motii8128/TRIA/README.md

# TRIA
Triple-wheel Robot for Intelligent Autonomous

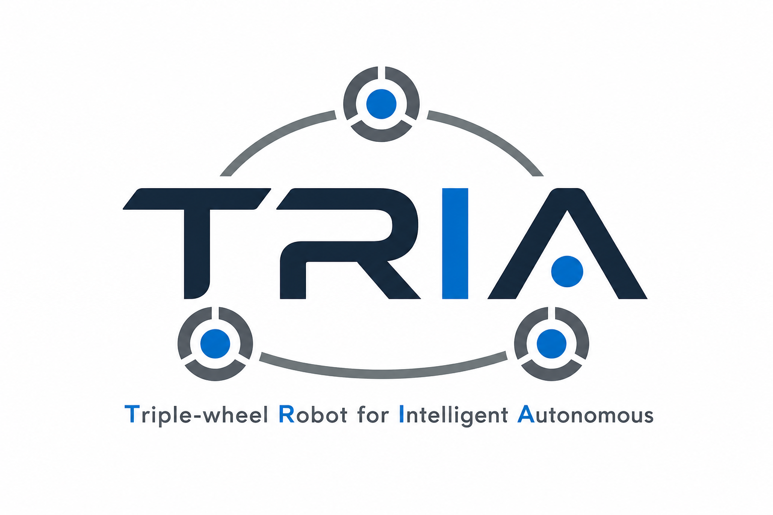
[picture p1: tria_logo.png]


# install
```
sudo apt install nlohmann-json3-dev
sudo apt install protobuf-compiler
```
