motii8128/TRIA/control_architecture.md

# 制御アーキテクチャ
```mermaid
graph TD

subgraph hardware
micro_controller <==> |CAN| RoboMaster
micro_controller <==> |CAN| MotorDriver
end

subgraph software
micro_controller_connector <==>|UDP| micro_controller
wheel_controller ==> micro_controller_connector
machine_controller ==> micro_controller_connector
tria_auto_core ==> wheel_controller
tria_auto_core ==> machine_controller
end
```
