motii8128/TRIA/tria_hardware/TRIA_ControlPowerBoard/TRIA_ControlPowerBoard.step

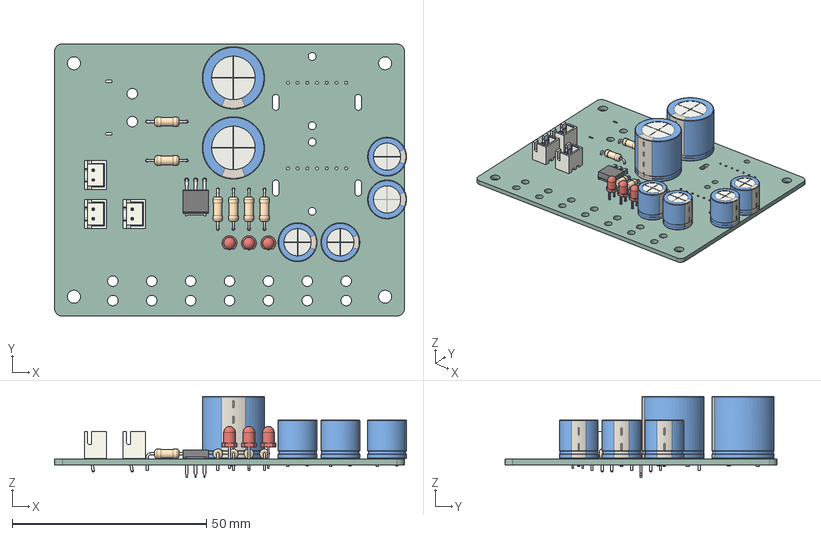
[picture p2: CAD file, 2026-09-30]
tria_hardware/TRIA_ControlPowerBoard/TRIA_ControlPowerBoard.step
90.5 x 70.0 x 20.8 mm
CP_Radial_D10.0mm_P5.00mm x 4
LED_D3.0mm x 3
R_Axial_DIN0207_L6.3mm_D2.5mm_P10.16mm_Horizontal x 6
JST_XH_B2B-XH-A_1x02_P2.50mm_Vertical x 3
CP_Radial_D16.0mm_P7.50mm x 2
TO-251-3-1EP_Horizontal_TabDown
TRIA_ControlPowerBoard_PCB
