motii8128/TRIA/tria_hardware/TRIA_CentralControlBoard/TRIA_CentralControlBoard.kicad_pcb

## KiCad design tria_hardware/TRIA_CentralControlBoard/TRIA_CentralControlBoard.kicad_pcb (2026-09-16)

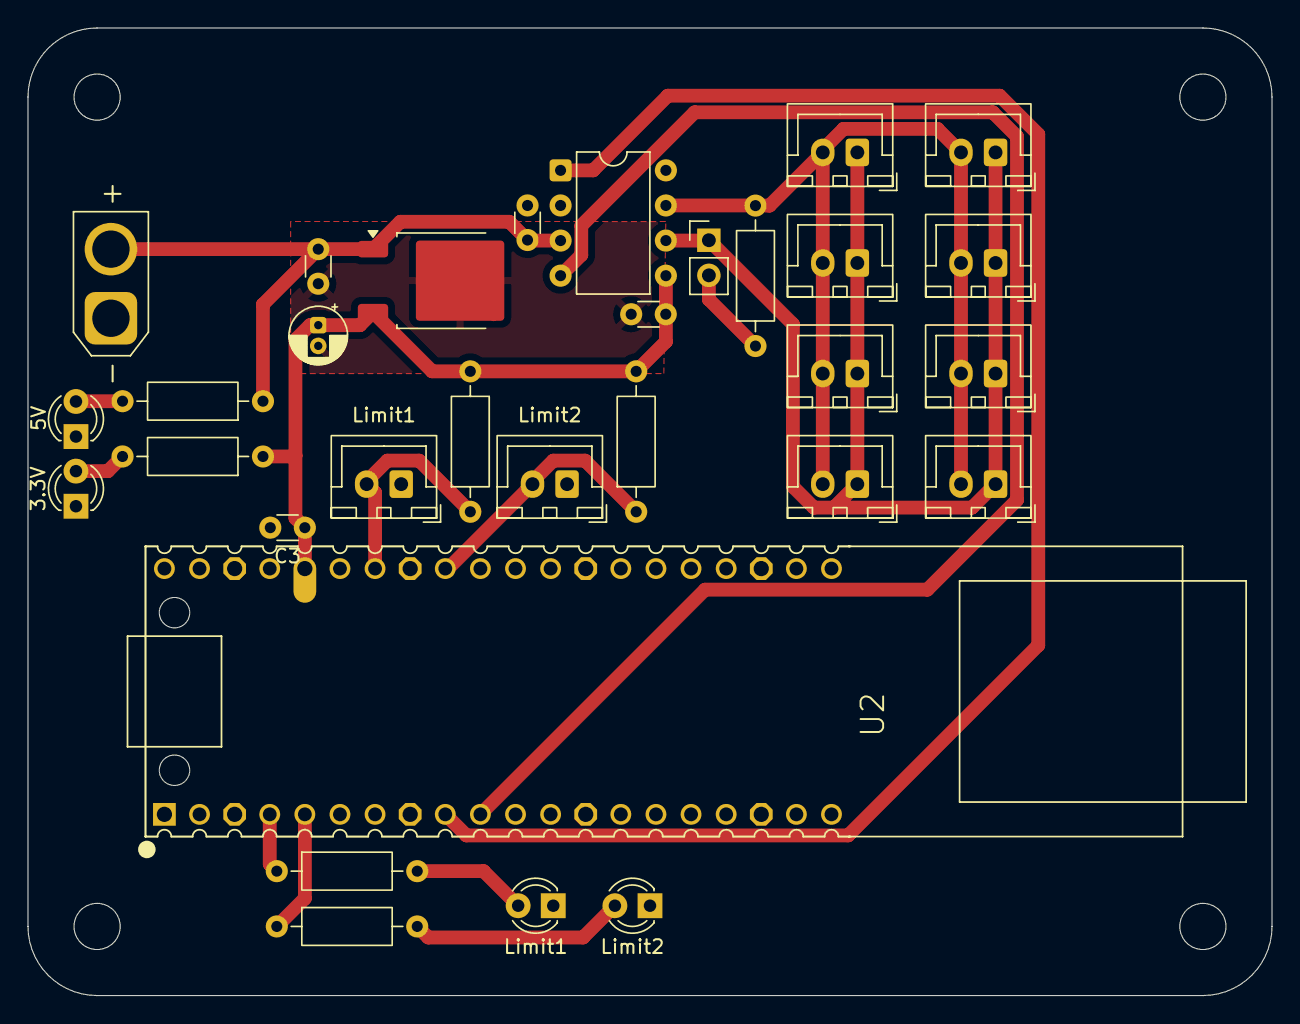
[picture p3: board TRIA_CentralControlBoard.kicad_pcb from above]

Board: 2 copper layers, 90.0 x 70.0 mm, 31 parts (0 on the bottom side), 16 nets.

Parts:
3.3V: GREEN; LED_D3.0mm
5V: BLUE; LED_D3.0mm
C1, C3, C14, C15: 0.1u; C_Disc_D3.0mm_W1.6mm_P2.50mm
C2: 10uF16V; CP_Radial_D4.0mm_P1.50mm
J1, J3, J4, J6, J7, J8, J9, J10: CAN; JST_XH_B2B-XH-A_1x02_P2.50mm_Vertical
J2: LogicBatt; AMASS_XT30U-M_1x02_P5.0mm_Vertical
J5: resistor_enable; PinHeader_1x02_P2.54mm_Vertical
Limit1: limit_switch1; JST_XH_B2B-XH-A_1x02_P2.50mm_Vertical
Limit1#2, Limit2#2: RED; LED_D3.0mm
Limit2: limit_switch2; JST_XH_B2B-XH-A_1x02_P2.50mm_Vertical
R1, R2: 10k; R_Axial_DIN0207_L6.3mm_D2.5mm_P10.16mm_Horizontal
R3, R4, R5, R6: 1k; R_Axial_DIN0207_L6.3mm_D2.5mm_P10.16mm_Horizontal
R17: 120; R_Axial_DIN0207_L6.3mm_D2.5mm_P10.16mm_Horizontal
U1: NJM2391DL1-33; TO-252-2
U2: W6300-EVB-PICO2; W5500-EVB-PICO-TH
U9: MCP2562-E-P; DIP-8_W7.62mm

Connections:
+3.3V: C2.1, C3.1, C14.1, R1.2, R2.2, R4.1, U1.3 (VO), U2.36 (3V3(OUT)), U9.5 (Vio)
/CAN/CAN_H: J1.2, J3.2, J4.2, J6.2, J7.2, J8.2, J9.2, J10.2, R17.2, U9.7 (CANH)
/CAN/CAN_L: J1.1, J3.1, J4.1, J5.1, J6.1, J7.1, J8.1, J9.1, J10.1, U9.6 (CANL)
/CAN/CAN_RX: U2.10 (GP7), U9.4 (RXD)
/CAN/CAN_TX: U2.9 (GP6), U9.1 (TXD)
/Limit_Switch/LimitSwitch1: Limit1.2, R1.1, U2.34 (GP28)
/Limit_Switch/LimitSwitch2: Limit2.2, R2.1, U2.32 (GP27)
GNDD: 3.3V.1 (K), 5V.1 (K), C1.2, C2.2, C3.2, C14.2, C15.2, J2.1, Limit1.1, Limit1#2.1 (K), Limit2.1, Limit2#2.1 (K), U1.2 (GND), U2.3 (GND), U2.8 (GND), U2.13 (GND), U2.18 (GND), U2.23 (GND), U2.28 (GND), U2.33 (GND), U2.37 (3V3_EN), U2.38 (GND), U9.2 (VSS), U9.8 (STBY)
LED1: R5.1, U2.4 (GP2)
LED2: R6.1, U2.5 (GP3)
unnamed: 5V.2 (A), R3.2
unnamed: 3.3V.2 (A), R4.2
unnamed: Limit1#2.2 (A), R5.2
unnamed: Limit2#2.2 (A), R6.2
unnamed: J5.2, R17.1
VDD: C1.1, C15.1, J2.2, R3.1, U1.1 (VI), U9.3 (VDD)
