motii8128/TRIA/tria_hardware/TRIA_LedControlBoard/TRIA_LedControlBoard.kicad_pcb

## KiCad design tria_hardware/TRIA_LedControlBoard/TRIA_LedControlBoard.kicad_pcb (2026-09-16)

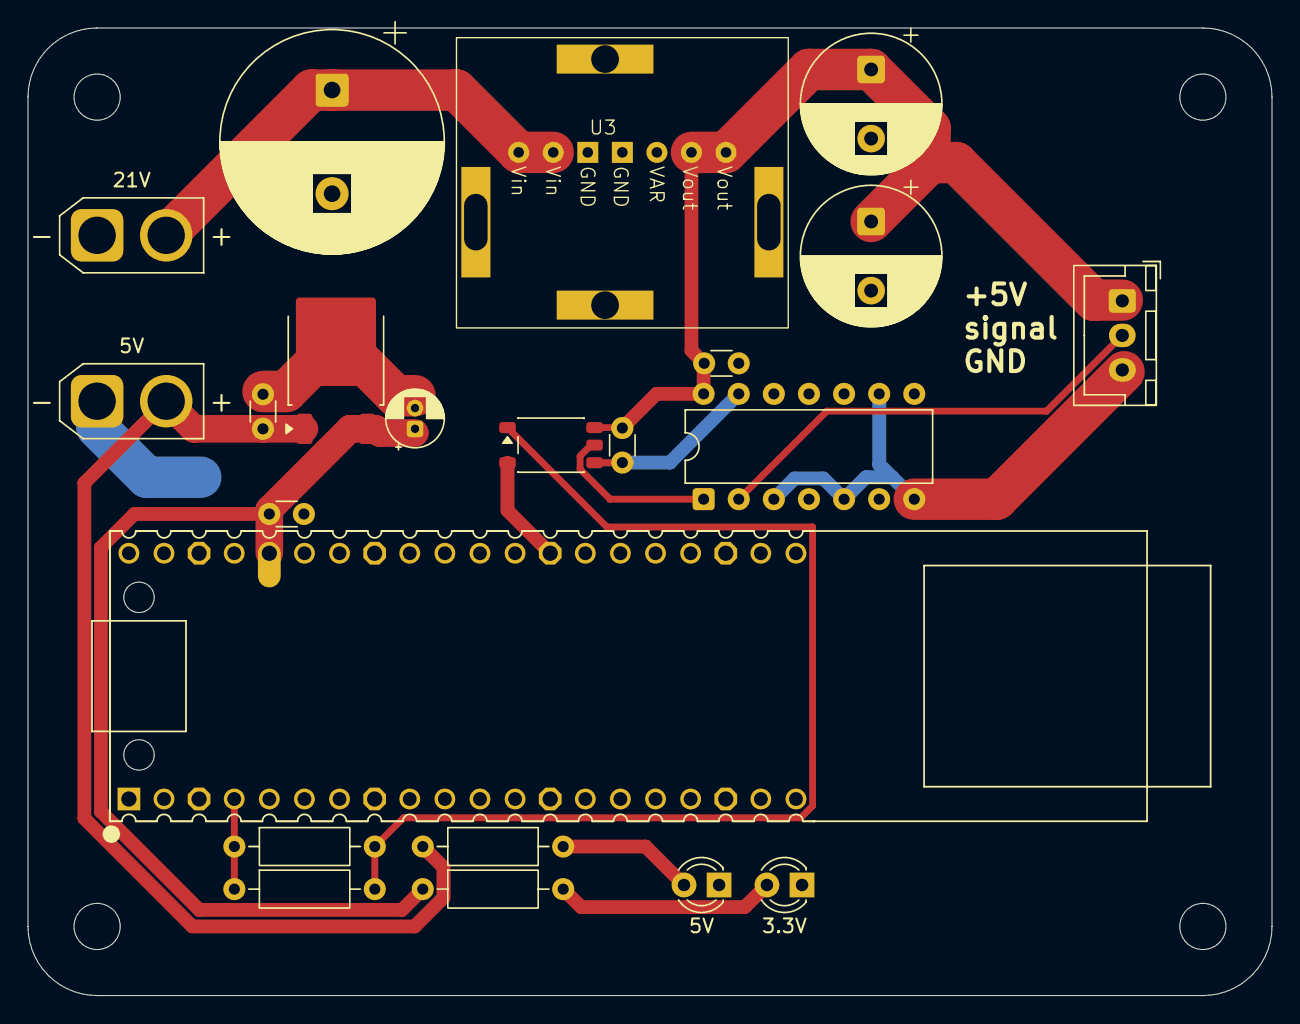
[picture p4: board TRIA_LedControlBoard.kicad_pcb from above]

Board: 2 copper layers, 90.0 x 70.0 mm, 22 parts (0 on the bottom side), 12 nets.

Parts:
3.3V: GREEN; LED_D3.0mm
5V: LogicBatt; AMASS_XT30U-M_1x02_P5.0mm_Vertical
5V#2: BLUE; LED_D3.0mm
21V: DriveBatt; AMASS_XT30U-M_1x02_P5.0mm_Vertical
C1, C3, C7, C8: 0.1u; C_Disc_D3.0mm_W1.6mm_P2.50mm
C2: 10uF16V; CP_Radial_D4.0mm_P1.50mm
C4: 1000uF50V; CP_Radial_D16.0mm_P7.50mm
C5, C6: 1000uF25V; CP_Radial_D10.0mm_P5.00mm
R1, R2, R3, R4: 1k; R_Axial_DIN0207_L6.3mm_D2.5mm_P10.16mm_Horizontal
U1: NJM2391DL1-33; TO-252-2
U2: W6300-EVB-PICO2; W5500-EVB-PICO-TH
U3: MPD7K020S
U4: TLP2361; SO-5-6_4.55x3.7mm_P1.27mm
U5: 74HC04; DIP-14_W7.62mm
WS2812: WS2812; JST_XH_B3B-XH-A_1x03_P2.50mm_Vertical

Connections:
+3.3V: C2.1, C3.1, R4.1, U1.3 (VO), U2.36 (3V3(OUT))
+5V: C5.1, C6.1, C7.1, C8.1, U3.6 (Vout), U3.7 (Vout), U4.6 (VDD), U5.14 (VCC), WS2812.1
+BATT: 21V.2, C4.1, U3.1 (Vin), U3.2 (Vin)
/PhotoCoupler/signal_in: R1.1, R2.1, U2.4 (GP2)
/PhotoCoupler/signal_out: U5.2, WS2812.2
GND: 21V.1, C4.2, C5.2, C6.2, C7.2, C8.2, U3.3 (GND), U3.4 (GND), U4.4 (GND), U5.3, U5.5, U5.7 (GND), U5.9, U5.11, U5.13, WS2812.3
GNDD: 3.3V.1 (K), 5V.1, 5V#2.1 (K), C1.2, C2.2, C3.2, U1.2 (GND), U2.3 (GND), U2.8 (GND), U2.13 (GND), U2.18 (GND), U2.23 (GND), U2.28 (GND), U2.33 (GND), U2.37 (3V3_EN), U2.38 (GND), U4.3 (K)
unnamed: 5V#2.2 (A), R3.2
unnamed: 3.3V.2 (A), R4.2
unnamed: R1.2, R2.2, U4.1 (A)
unnamed: U4.5 (VO), U5.1
VDD: 5V.2, C1.1, R3.1, U1.1 (VI)
