motii8128/TRIA/tria_hardware/TRIA_ControlPowerBoard/TRIA_ControlPowerBoard.kicad_pcb

## KiCad design tria_hardware/TRIA_ControlPowerBoard/TRIA_ControlPowerBoard.kicad_pcb (2026-09-10)

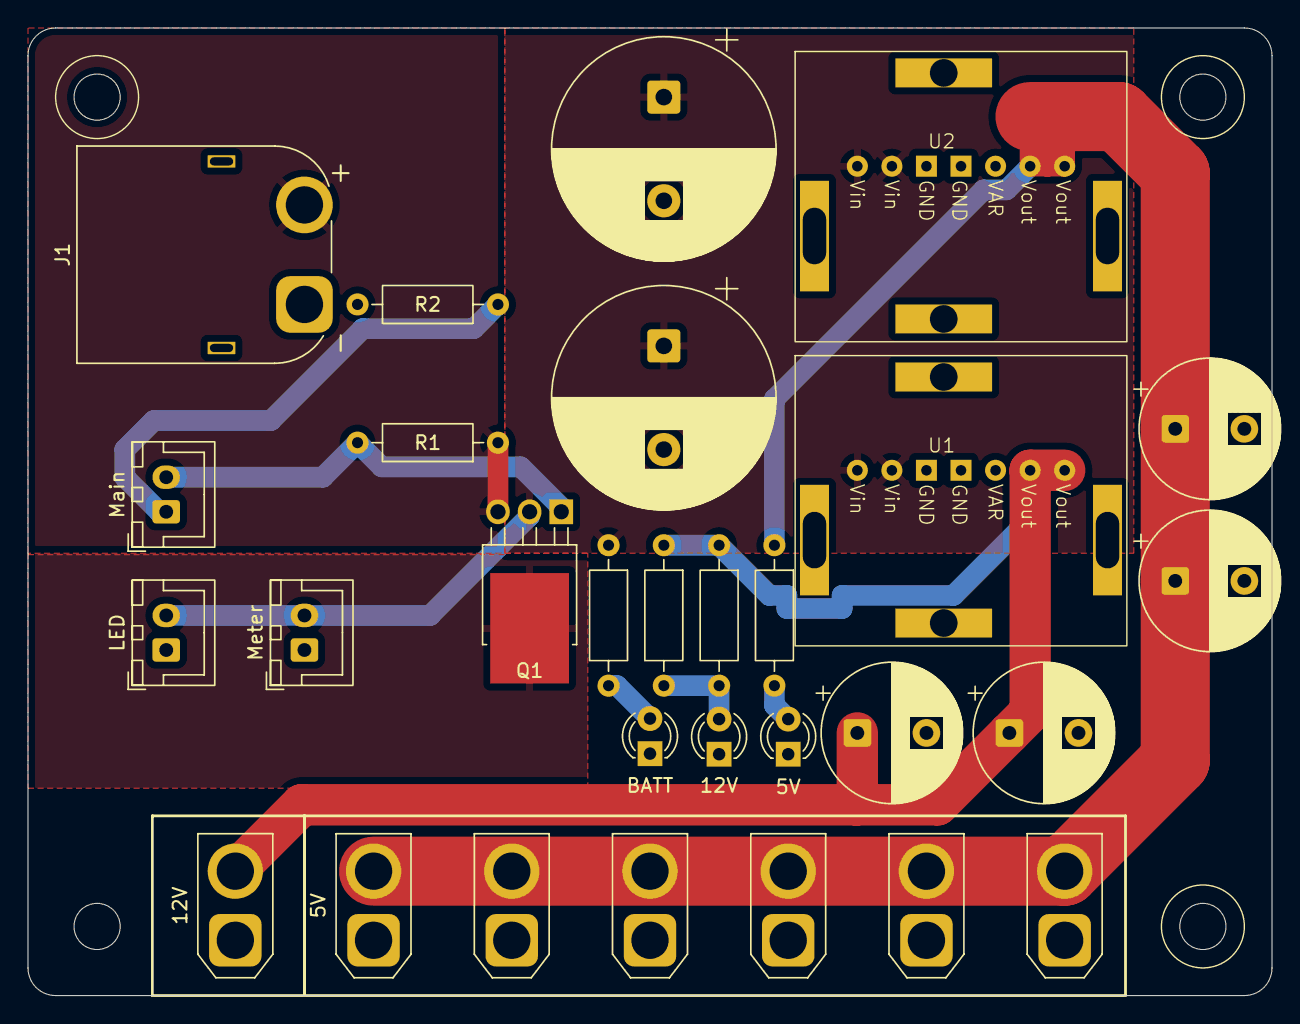
[picture p5: board TRIA_ControlPowerBoard.kicad_pcb from above]

Board: 2 copper layers, 90.0 x 70.0 mm, 29 parts (0 on the bottom side), 10 nets.

Parts:
5V: GREEN; LED_D3.0mm
5V#2: out5V; AMASS_XT30U-F_1x02_P5.0mm_Vertical
12V: out12V; AMASS_XT30U-F_1x02_P5.0mm_Vertical
12V#2: RED; LED_D3.0mm
BATT: BLUE; LED_D3.0mm
C1, C4: 1000uF50V; CP_Radial_D16.0mm_P7.50mm
C2, C3, C5, C6: 1000uF25V; CP_Radial_D10.0mm_P5.00mm
J1: Batt; AMASS_XT60PW-M_1x02_P7.20mm_Horizontal
J2, J4, J8, J9, J10: out5V; AMASS_XT30U-F_1x02_P5.0mm_Vertical
LED: SW_LED; JST_XH_B2B-XH-A_1x02_P2.50mm_Vertical
Main: power_swtich; JST_XH_B2B-XH-A_1x02_P2.50mm_Vertical
Meter: voltage_meter; JST_XH_B2B-XH-A_1x02_P2.50mm_Vertical
Q1: MTP4835I3; TO-251-3-1EP_Horizontal_TabDown
R1, R2: 10k; R_Axial_DIN0207_L6.3mm_D2.5mm_P10.16mm_Horizontal
R3, R4, R5: 1k; R_Axial_DIN0207_L6.3mm_D2.5mm_P10.16mm_Horizontal
R6: 120; R_Axial_DIN0207_L6.3mm_D2.5mm_P10.16mm_Horizontal
U1, U2: MPD7K020S

Connections:
+5V: 5V#2.2, C5.1, C6.1, J2.2, J4.2, J8.2, J9.2, J10.2, R6.1, U2.6 (Vout), U2.7 (Vout)
+12V: 12V.2, C2.1, C3.1, R4.1, R5.1, U1.6 (Vout), U1.7 (Vout)
+BATT: C1.1, C4.1, LED.2, Meter.2, Q1.1 (D), R3.1, U1.1 (Vin), U1.2 (Vin), U2.1 (Vin), U2.2 (Vin)
GND: 5V.1 (K), 5V#2.1, 12V.1, 12V#2.1 (K), BATT.1 (K), C1.2, C2.2, C3.2, C4.2, C5.2, C6.2, J1.1, J2.1, J4.1, J8.1, J9.1, J10.1, LED.1, Meter.1, R2.2, U1.3 (GND), U1.4 (GND), U1.5 (VAR), U2.3 (GND), U2.4 (GND)
unnamed: BATT.2 (A), R3.2
unnamed: 12V#2.2 (A), R4.2, R5.2
unnamed: 5V.2 (A), R6.2
unnamed: J1.2, Q1.3 (S), R1.1
unnamed: Main.1, R2.1
unnamed: Main.2, Q1.2 (G), R1.2
