motii8128/TRIA/tria_hardware/TRIA_MotorDrive/TRIA_MotorDrive.kicad_pcb

## KiCad design tria_hardware/TRIA_MotorDrive/TRIA_MotorDrive.kicad_pcb (2026-09-10)

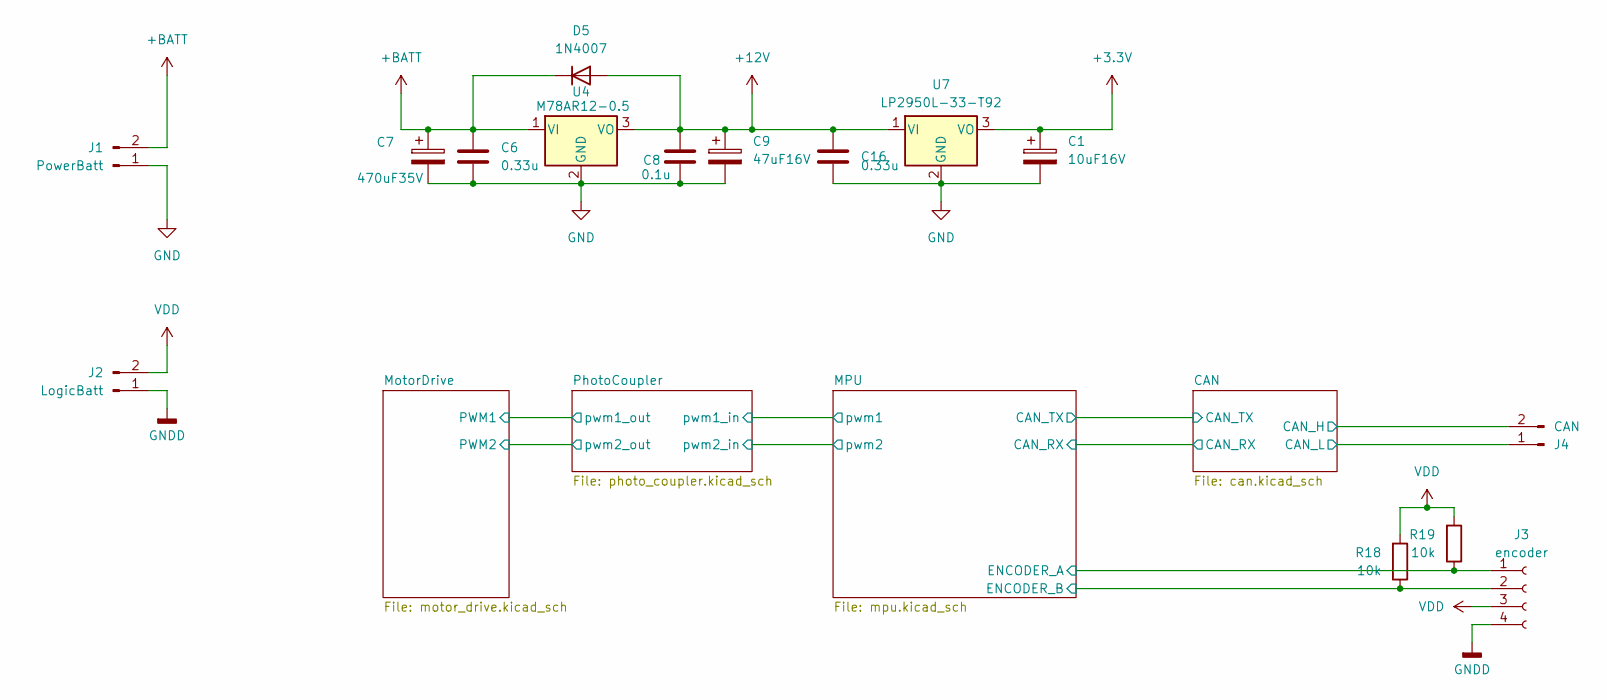
[picture p6: schematic TRIA_MotorDrive.kicad_sch]

Parts:
C1: 10uF16V; CP_Radial_D4.0mm_P1.50mm
C6, C16: 0.33u; C_Disc_D3.0mm_W1.6mm_P2.50mm
C7: 470uF35V; CP_Radial_D10.0mm_P5.00mm
C8: 0.1u; C_Disc_D3.0mm_W1.6mm_P2.50mm
C9: 47uF16V; CP_Radial_D5.0mm_P2.00mm
D5: 1N4007; D_DO-41_SOD81_P7.62mm_Horizontal
J1: PowerBatt; AMASS_XT60-M_1x02_P7.20mm_Vertical
J2: LogicBatt; AMASS_XT30U-M_1x02_P5.0mm_Vertical
J3: encoder; JST_XH_B4B-XH-A_1x04_P2.50mm_Vertical
J4: CAN; JST_XH_B2B-XH-A_1x02_P2.50mm_Vertical
R18, R19: 10k; R_Axial_DIN0207_L6.3mm_D2.5mm_P10.16mm_Horizontal
U4: M78AR12-0.5; m78ar033-1
U7: LP2950L-33-T92; TO-92L_Inline

Connections:
+3.3V: C1.1, U7.3 (VO); also elsewhere on the board
+12V: C8.1, C9.1, C16.1, D5.2 (A), U4.3 (VO), U7.1 (VI)
+BATT: C6.1, C7.1, D5.1 (K), J1.2, U4.1 (VI); also elsewhere on the board
/CAN/CAN_H: J4.2; also elsewhere on the board
/CAN/CAN_L: J4.1; also elsewhere on the board
/MPU/ENCODER_A: J3.1, R19.1; also elsewhere on the board
/MPU/ENCODER_B: J3.2, R18.1; also elsewhere on the board
GND: C1.2, C6.2, C7.2, C8.2, C9.2, C16.2, J1.1, U4.2 (GND), U7.2 (GND); also elsewhere on the board
GNDD: J2.1, J3.4; also elsewhere on the board
VDD: J2.2, J3.3, R18.2, R19.2; also elsewhere on the board

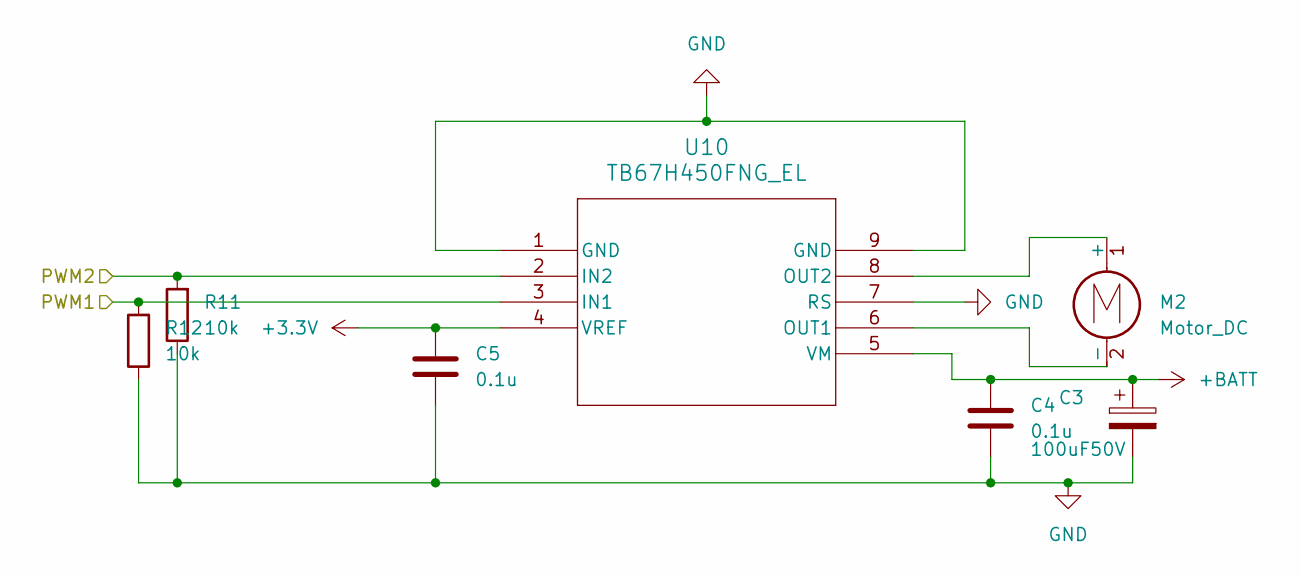
[picture p7: schematic motor_drive.kicad_sch]

Parts:
C3: 100uF50V; CP_Radial_D8.0mm_P3.50mm
C4, C5: 0.1u; C_Disc_D3.0mm_W1.6mm_P2.50mm
M2: Motor_DC; AMASS_XT60-F_1x02_P7.20mm_Vertical
R11, R12: 10k; R_Axial_DIN0207_L6.3mm_D2.5mm_P10.16mm_Horizontal
U10: TB67H450FNG_EL; P-HSOP8-0405-1p27-002_TOS

Connections:
+3.3V: C5.1, U10.4 (VREF); also elsewhere on the board
+BATT: C3.1, C4.1, U10.5 (VM); also elsewhere on the board
/MotorDrive/PWM1: R12.2, U10.3 (IN1); also elsewhere on the board
/MotorDrive/PWM2: R11.2, U10.2 (IN2); also elsewhere on the board
GND: C3.2, C4.2, C5.2, R11.1, R12.1, U10.1 (GND), U10.7 (RS), U10.9 (GND); also elsewhere on the board
unnamed: M2.1 (+), U10.8 (OUT2)
unnamed: M2.2 (-), U10.6 (OUT1)

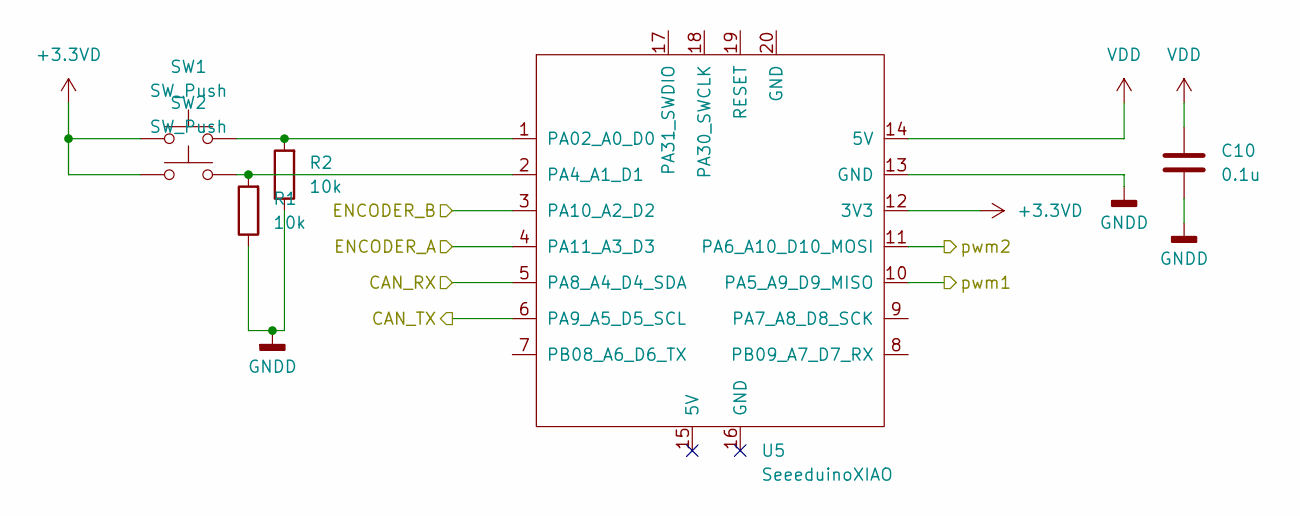
[picture p8: schematic mpu.kicad_sch]

Parts:
C10: 0.1u; C_Disc_D3.0mm_W1.6mm_P2.50mm
R1, R2: 10k; R_Axial_DIN0207_L6.3mm_D2.5mm_P10.16mm_Horizontal
SW1, SW2: SW_Push; SW_PUSH_6mm
U5: SeeeduinoXIAO; Seeeduino XIAO-MOUDLE14P-2.54-21X17.8MM

Connections:
+3.3VD: SW1.1, SW2.1, U5.12 (3V3); also elsewhere on the board
/CAN/CAN_RX: U5.5 (PA8_A4_D4_SDA); also elsewhere on the board
/CAN/CAN_TX: U5.6 (PA9_A5_D5_SCL); also elsewhere on the board
/MPU/ENCODER_A: U5.4 (PA11_A3_D3); also elsewhere on the board
/MPU/ENCODER_B: U5.3 (PA10_A2_D2); also elsewhere on the board
/MPU/pwm1: U5.10 (PA5_A9_D9_MISO); also elsewhere on the board
/MPU/pwm2: U5.11 (PA6_A10_D10_MOSI); also elsewhere on the board
GNDD: C10.2, R1.1, R2.1, U5.13 (GND); also elsewhere on the board
unnamed: R2.2, SW1.2, U5.1 (PA02_A0_D0)
unnamed: R1.2, SW2.2, U5.2 (PA4_A1_D1)
VDD: C10.1, U5.14 (5V); also elsewhere on the board

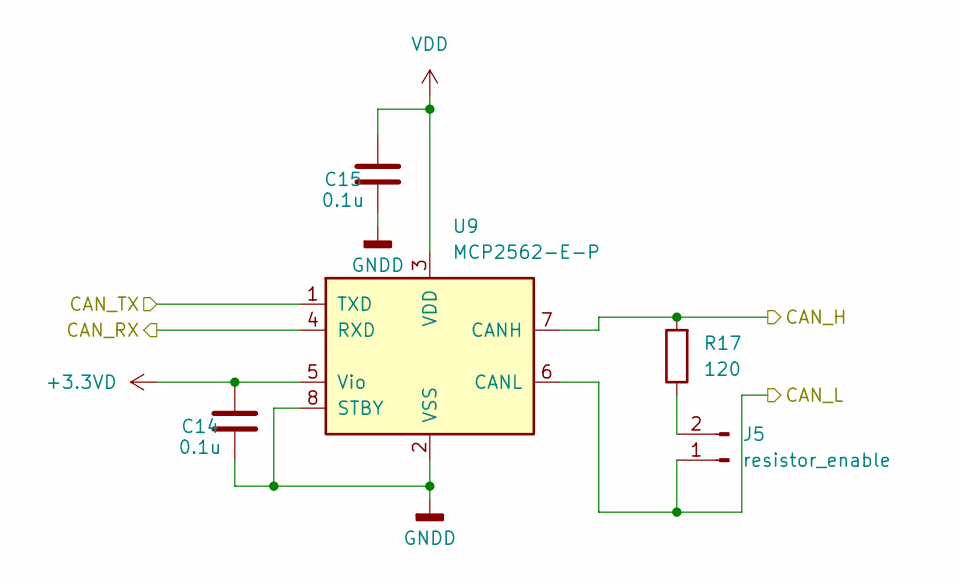
[picture p9: schematic can.kicad_sch]

Parts:
C14, C15: 0.1u; C_Disc_D3.0mm_W1.6mm_P2.50mm
J5: resistor_enable; PinHeader_1x02_P2.54mm_Vertical
R17: 120; R_Axial_DIN0207_L6.3mm_D2.5mm_P10.16mm_Horizontal
U9: MCP2562-E-P; DIP-8_W7.62mm

Connections:
+3.3VD: C14.1, U9.5 (Vio); also elsewhere on the board
/CAN/CAN_H: R17.2, U9.7 (CANH); also elsewhere on the board
/CAN/CAN_L: J5.1, U9.6 (CANL); also elsewhere on the board
/CAN/CAN_RX: U9.4 (RXD); also elsewhere on the board
/CAN/CAN_TX: U9.1 (TXD); also elsewhere on the board
GNDD: C14.2, C15.2, U9.2 (VSS), U9.8 (STBY); also elsewhere on the board
unnamed: J5.2, R17.1
VDD: C15.1, U9.3 (VDD); also elsewhere on the board

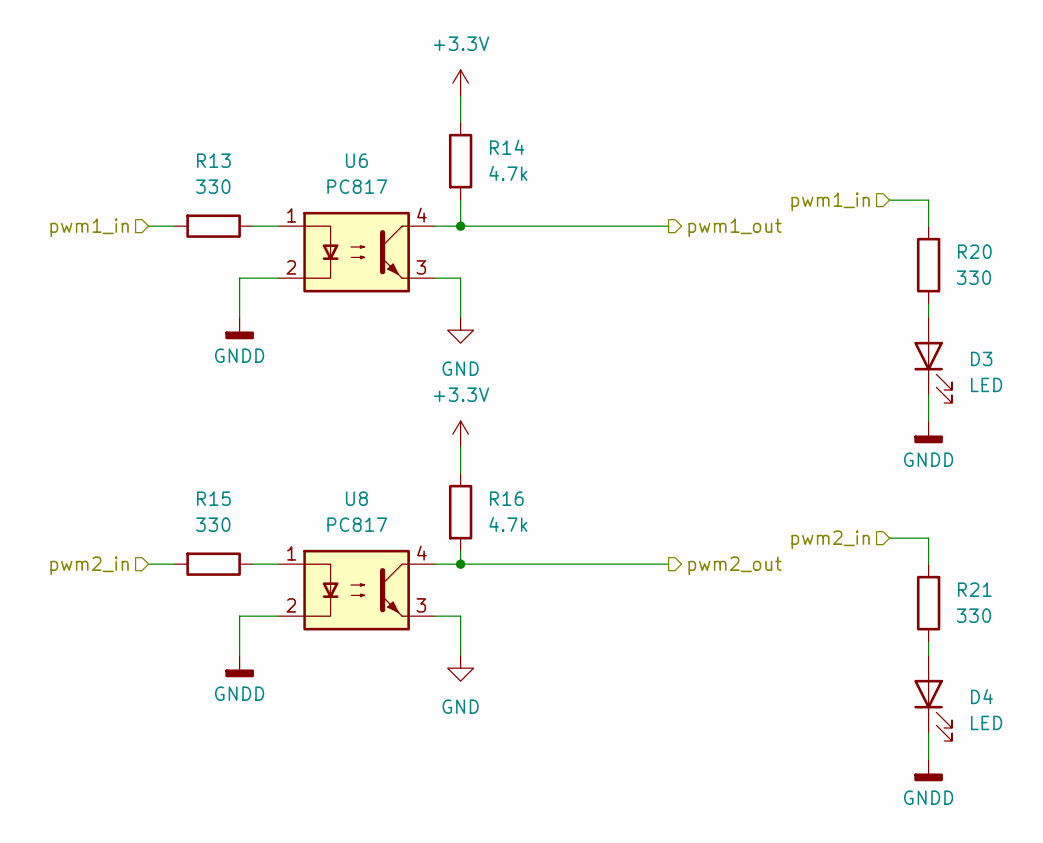
[picture p10: schematic photo_coupler.kicad_sch]

Parts:
D3, D4: LED; LED_D3.0mm
R13, R15, R20, R21: 330; R_1206_3216Metric_Pad1.30x1.75mm_HandSolder
R14, R16: 4.7k; R_1206_3216Metric_Pad1.30x1.75mm_HandSolder
U6, U8: PC817; DIP-4_W7.62mm

Connections:
+3.3V: R14.1, R16.1; also elsewhere on the board
/MPU/pwm1: R13.2, R20.2; also elsewhere on the board
/MPU/pwm2: R15.2, R21.2; also elsewhere on the board
/MotorDrive/PWM1: R14.2, U6.4; also elsewhere on the board
/MotorDrive/PWM2: R16.2, U8.4; also elsewhere on the board
GND: U6.3, U8.3; also elsewhere on the board
GNDD: D3.1 (K), D4.1 (K), U6.2, U8.2; also elsewhere on the board
unnamed 16: D3.2 (A), R20.1; also elsewhere on the board
unnamed 17: D4.2 (A), R21.1; also elsewhere on the board
unnamed: R13.1, U6.1
unnamed: R15.1, U8.1

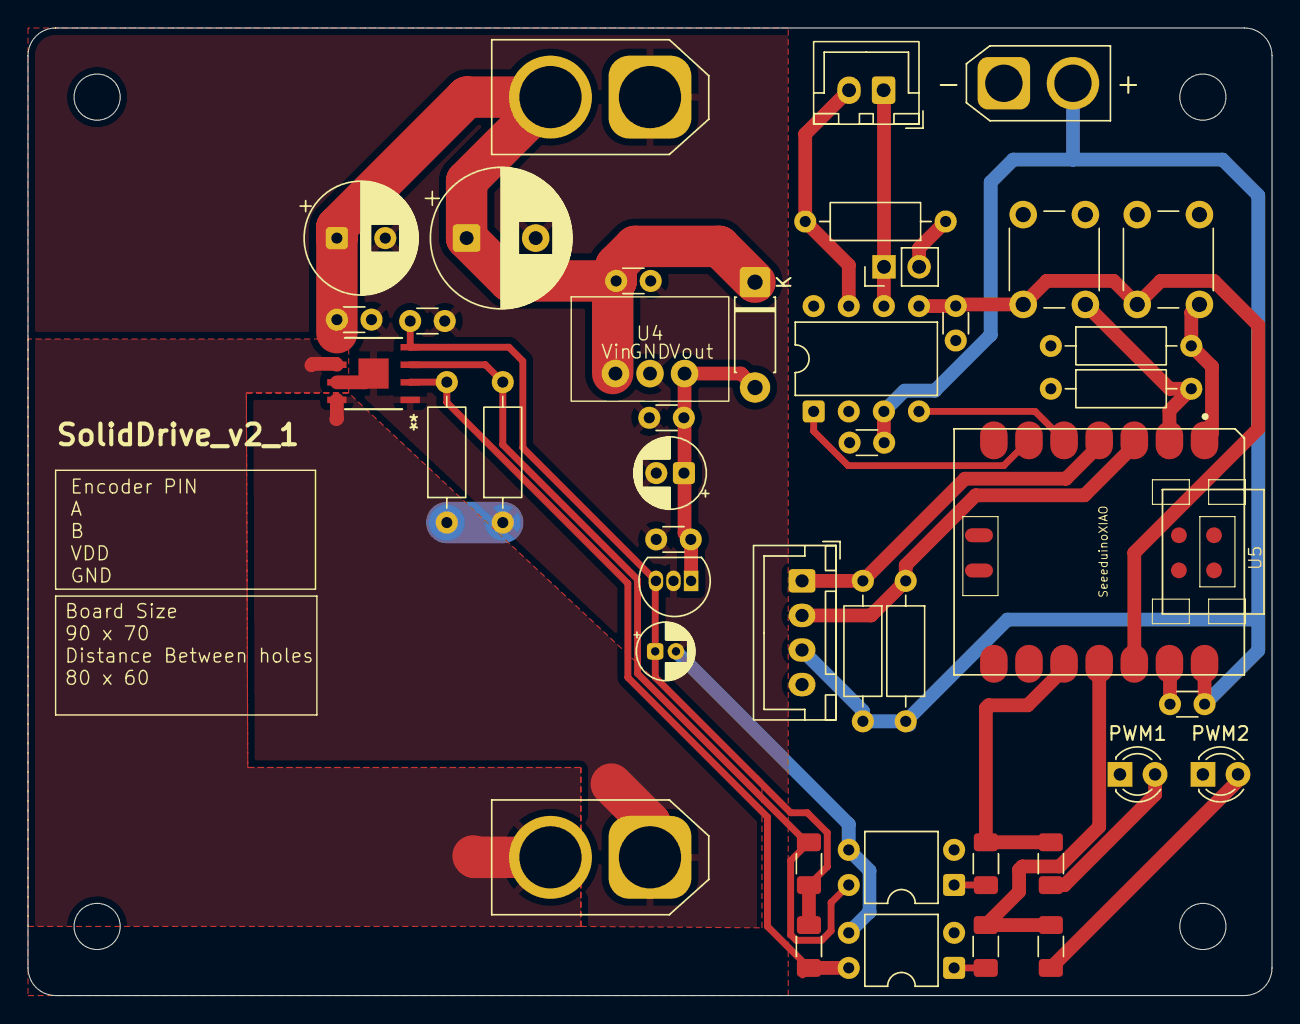
[picture p11: board TRIA_MotorDrive.kicad_pcb from above]

Board: 2 copper layers, 90.0 x 70.0 mm, 43 parts (0 on the bottom side), 26 nets.

Other parts of the board:
PWM1, PWM2: LED; LED_D3.0mm

Their connections:
GNDD: PWM1.1 (K), PWM2.1 (K); also elsewhere on the board
unnamed 16: PWM1.2 (A); also elsewhere on the board
unnamed 17: PWM2.2 (A); also elsewhere on the board
