motii8128/TRIA/tria_hardware/TRIA_DrivePowerBoard/TRIA_DrivePowerBoard.kicad_pcb

## KiCad design tria_hardware/TRIA_DrivePowerBoard/TRIA_DrivePowerBoard.kicad_pcb (2026-09-10)

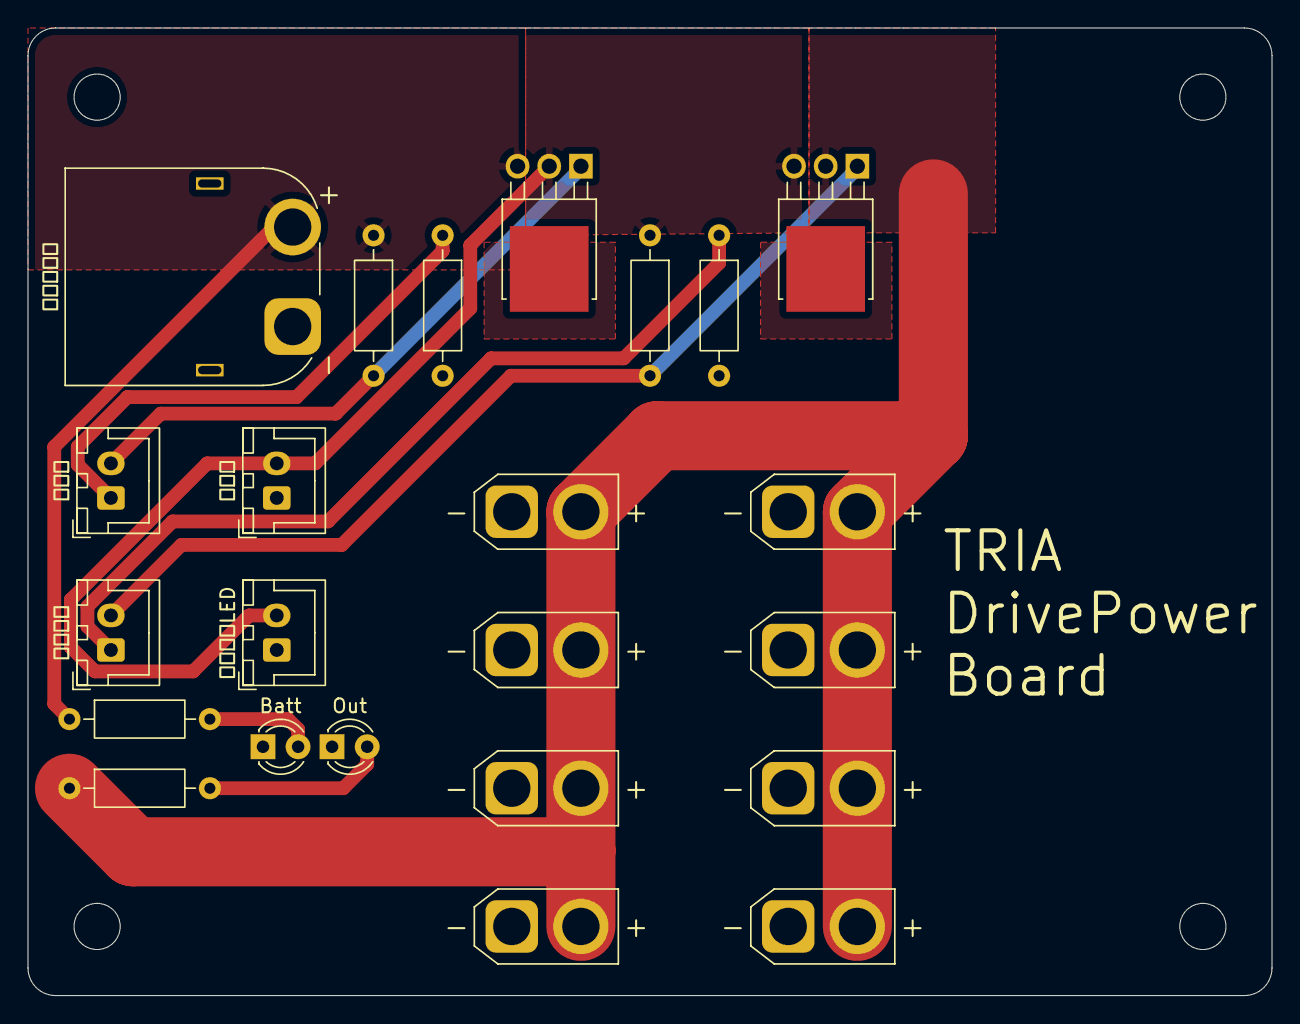
[picture p12: board TRIA_DrivePowerBoard.kicad_pcb from above]

Board: 2 copper layers, 90.0 x 70.0 mm, 23 parts (0 on the bottom side), 10 nets.

Parts:
Batt: BLUE; LED_D3.0mm
J3, J4, J5, J8, J9, J10, J11, J12: out; AMASS_XT30U-F_1x02_P5.0mm_Vertical
Out: Green; LED_D3.0mm
Q1, Q2: MTP4835I3; TO-251-3-1EP_Horizontal_TabDown
R1, R2, R3, R4: 10k; R_Axial_DIN0207_L6.3mm_D2.5mm_P10.16mm_Horizontal
R5, R6: 1k; R_Axial_DIN0207_L6.3mm_D2.5mm_P10.16mm_Horizontal
スイッチLED: sw_led; JST_XH_B2B-XH-A_1x02_P2.50mm_Vertical
バッテリー: Batt; AMASS_XT60PW-M_1x02_P7.20mm_Horizontal
主電源: power_swtich; JST_XH_B2B-XH-A_1x02_P2.50mm_Vertical
緊急停止: emergency; JST_XH_B2B-XH-A_1x02_P2.50mm_Vertical
電圧計: voltage_meter; JST_XH_B2B-XH-A_1x02_P2.50mm_Vertical

Connections:
+BATT: Q1.3 (S), R1.1, R5.1, バッテリー.2
GND: Batt.1 (K), J3.1, J4.1, J5.1, J8.1, J9.1, J10.1, J11.1, J12.1, Out.1 (K), R2.2, R4.2, スイッチLED.1, バッテリー.1, 電圧計.1
unnamed: Batt.2 (A), R5.2
unnamed: Out.2 (A), R6.2
unnamed: R4.1, 緊急停止.1
unnamed: Q2.2 (G), R3.2, 緊急停止.2
unnamed: R2.1, 主電源.1
unnamed: Q1.2 (G), R1.2, 主電源.2
non_emergency: Q1.1 (D), Q2.3 (S), R3.1, スイッチLED.2, 電圧計.2
out: J3.2, J4.2, J5.2, J8.2, J9.2, J10.2, J11.2, J12.2, Q2.1 (D), R6.1
