motii8128/TRIA/tria_hardware/SolidDrive_v2_1/SolidDrive_v2_1.kicad_pcb

## KiCad design tria_hardware/SolidDrive_v2_1/SolidDrive_v2_1.kicad_pcb (2026-08-23)

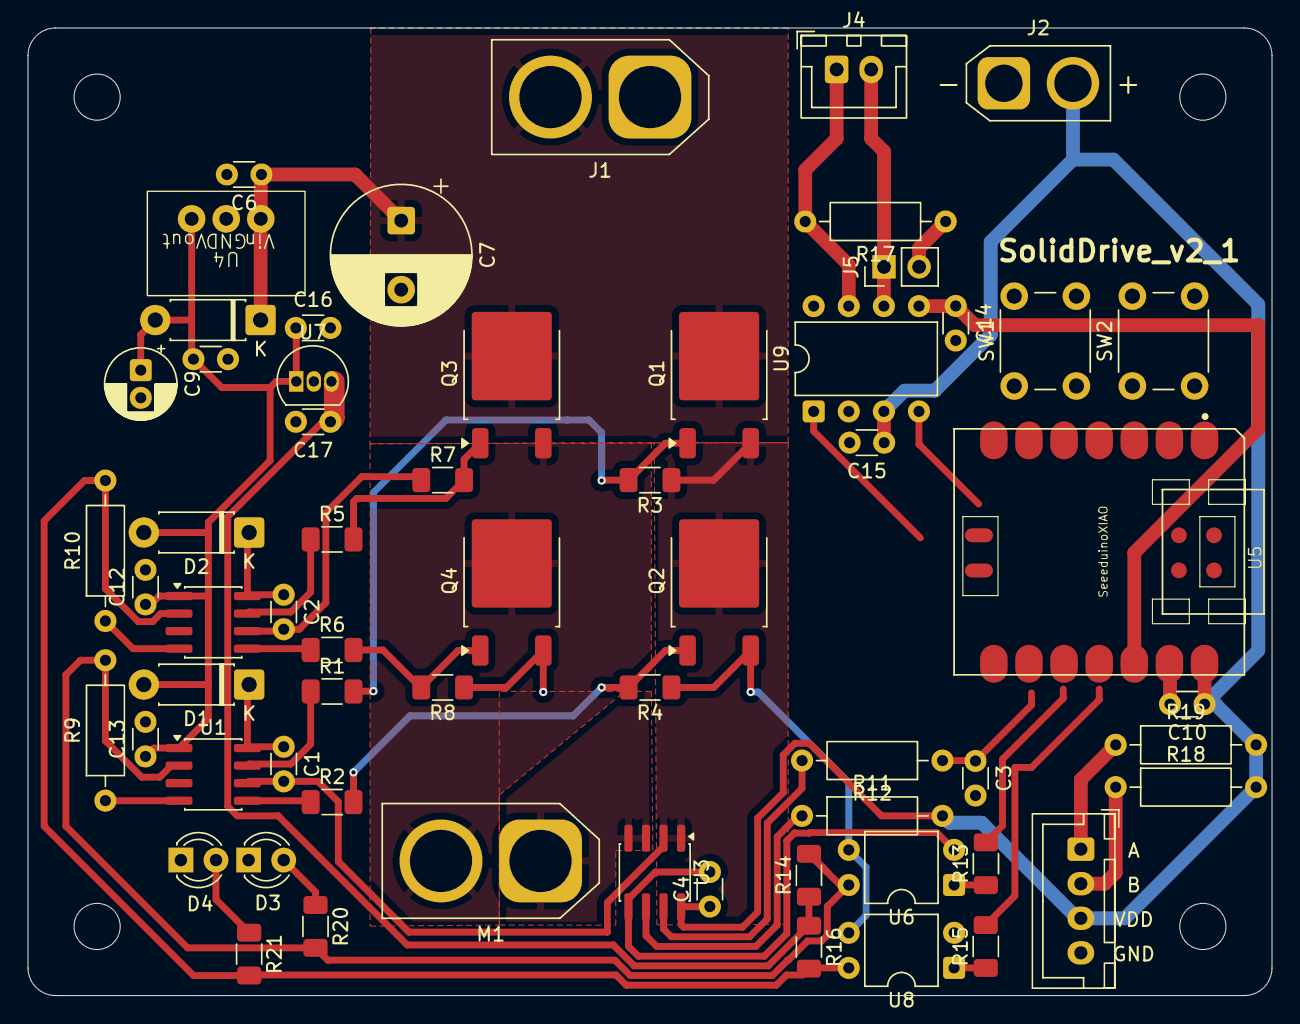
[picture p13: board SolidDrive_v2_1.kicad_pcb from above]

Board: 2 copper layers, 90.0 x 70.0 mm, 62 parts (0 on the bottom side), 35 nets.

Parts:
C1, C2: 1u; C_Disc_D3.0mm_W1.6mm_P2.50mm
C3, C4, C8, C10, C12, C13, C14, C15, C17: 0.1u; C_Disc_D3.0mm_W1.6mm_P2.50mm
C6, C16: 0.33u; C_Disc_D3.0mm_W1.6mm_P2.50mm
C7: 470uF35V; CP_Radial_D10.0mm_P5.00mm
C9: 47uF16V; CP_Radial_D5.0mm_P2.00mm
D1, D2: 1N5819; D_DO-41_SOD81_P7.62mm_Horizontal
D3, D4: LED; LED_D3.0mm
D5: 1N4007; D_DO-41_SOD81_P7.62mm_Horizontal
J1: PowerBatt; AMASS_XT60-M_1x02_P7.20mm_Vertical
J2: LogicBatt; AMASS_XT30U-M_1x02_P5.0mm_Vertical
J3: encoder; JST_XH_B4B-XH-A_1x04_P2.50mm_Vertical
J4: CAN; JST_XH_B2B-XH-A_1x02_P2.50mm_Vertical
J5: resistor_enable; PinHeader_1x02_P2.54mm_Vertical
M1: Motor_DC; AMASS_XT60-F_1x02_P7.20mm_Vertical
Q1: MTB7D0N06RJ3; TO-252-2
Q2: LOW1; TO-252-2
Q3: HIGH2; TO-252-2
Q4: LOW2; TO-252-2
R1, R2, R5, R6: 10; R_1206_3216Metric_Pad1.30x1.75mm_HandSolder
R3, R4, R7, R8: 10k; R_1206_3216Metric_Pad1.30x1.75mm_HandSolder
R9, R10, R18, R19: 10k; R_Axial_DIN0207_L6.3mm_D2.5mm_P10.16mm_Horizontal
R11: PullUp; R_Axial_DIN0207_L6.3mm_D2.5mm_P10.16mm_Horizontal
R12: 1k; R_Axial_DIN0207_L6.3mm_D2.5mm_P10.16mm_Horizontal
R13, R15, R20, R21: 330; R_1206_3216Metric_Pad1.30x1.75mm_HandSolder
R14, R16: 4.7k; R_1206_3216Metric_Pad1.30x1.75mm_HandSolder
R17: 120; R_Axial_DIN0207_L6.3mm_D2.5mm_P10.16mm_Horizontal
SW1, SW2: SW_Push; SW_PUSH_6mm
U1, U2: IR2302; SOIC-8_3.9x4.9mm_P1.27mm
U3: ACS711xLCTR-12AB; SOIC-8_3.9x4.9mm_P1.27mm
U4: M78AR12-0.5; m78ar033-1
U5: SeeeduinoXIAO; Seeeduino XIAO-MOUDLE14P-2.54-21X17.8MM
U6, U8: PC817; DIP-4_W7.62mm
U7: TA78L05S; TO-92L_Inline
U9: MCP2562-E-P; DIP-8_W7.62mm

Connections:
+3.3V: C14.1, U5.12 (3V3), U9.5 (Vio)
+5V: C17.1, R14.1, R16.1, U7.3 (VO)
+12V: C8.1, C9.1, C12.1, C13.1, C16.1, D1.2 (A), D2.2 (A), D5.2 (A), U1.1 (VCC), U2.1 (VCC), U4.3 (VO), U7.1 (VI)
+BATT: C6.1, C7.1, D5.1 (K), J1.2, Q1.2 (D), Q3.2 (D), U4.1 (VI)
/CAN/CAN_H: J4.1, R17.2, U9.7 (CANH)
/CAN/CAN_L: J4.2, J5.1, U9.6 (CANL)
/MPU/CurrentSensor: C3.1, R12.1
/MPU/ENCODER_A: J3.1, R19.1
/MPU/ENCODER_B: J3.2, R18.1
/MotorDrive/CurrentSensor/IP+: C1.2, Q1.3 (S), Q2.2 (D), R3.1, U1.6 (VS), U3.1 (IP+), U3.2 (IP+)
/MotorDrive/CurrentSensor/IP-: M1.1 (+), U3.3 (IP-), U3.4 (IP-)
/MotorDrive/PWM1: R9.2, R14.2, R20.2, U1.2 (IN), U6.4
/MotorDrive/PWM2: R10.2, R16.2, R21.2, U2.2 (IN), U8.4
GND: C6.2, C7.2, C8.2, C9.2, C12.2, C13.2, C16.2, C17.2, D3.1 (K), D4.1 (K), J1.1, Q2.3 (S), Q4.3 (S), R4.1, R8.1, R9.1, R10.1, U1.4 (COM), U2.4 (COM), U4.2 (GND), U6.3, U7.2 (GND), U8.3
GNDD: C3.2, C4.2, C10.2, C14.2, C15.2, J2.1, J3.4, U3.5 (GND), U5.13 (GND), U6.2, U8.2, U9.2 (VSS), U9.8 (STBY)
unnamed: C1.1, D1.1 (K), U1.8 (VB)
unnamed: C2.1, D2.1 (K), U2.8 (VB)
unnamed: D3.2 (A), R20.1
unnamed: D4.2 (A), R21.1
unnamed: J5.2, R17.1
unnamed: M1.2 (-), Q3.3 (S), Q4.2 (D)
unnamed: Q1.1 (G), R1.2, R3.2
unnamed: Q2.1 (G), R2.2, R4.2
unnamed: Q3.1 (G), R5.2, R7.2
unnamed: Q4.1 (G), R6.2, R8.2
unnamed: R13.1, U6.1
unnamed: R15.1, U8.1
unnamed: R1.1, U1.7 (HO)
unnamed: R2.1, U1.5 (LO)
unnamed: R5.1, U2.7 (HO)
unnamed: R6.1, U2.5 (LO)
unnamed: C2.2, R7.1, U2.6 (VS)
unnamed: R12.2, U3.7 (VIOUT)
unnamed: R11.1, U3.6 (~FAULT)
VDD: C4.1, C10.1, C15.1, J2.2, J3.3, R11.2, R18.2, R19.2, U3.8 (VCC), U5.14 (5V), U9.3 (VDD)
