motii8128/TRIA/tria_firmware/LAN2CAN_Bridge/LAN2CAN_Bridge.c

#include <stdio.h>
#include "pico/stdlib.h"
#include "pico/multicore.h"

#include "user_config.h"

// CAN通信ライブラリ
#include "can.h"
// ロボマスライブラリ
#include "robomaster.h"

// メッセージが定義されている
#include "tria_message/tria_message.h"

// UDP通信タスクが定義されている
#include "UDP_Task.h"


int main()
{
    stdio_init_all();
    mutex_init(&g_mutex);

    gpio_init(PICO_DEFAULT_LED_PIN);
    gpio_set_dir(PICO_DEFAULT_LED_PIN, true);

    gpio_init(2);
    gpio_set_dir(2, true);
    gpio_put(2, false);
    gpio_init(3);
    gpio_set_dir(3, true);
    gpio_put(3, false);

    canbus_setup(CAN_TX, CAN_RX, CAN_BIT_RATE);

    struct can2040_msg can_send_msg = {
        .id = 0x200,
        .dlc = 8,
        .data = {0,0,0,0,0,0,0,0}
    };

    struct can2040_msg md_send_msg = {
        .id = 0x300,
        .dlc = 8,
        .data = {0,0,0,0,0,0,0,0}
    };

    RoboMasterSensor rm1 = hp_sensor_init();
    RoboMasterSensor rm2 = hp_sensor_init();
    RoboMasterSensor rm3 = hp_sensor_init();

    tria_CommandPacket command = tria_CommandPacket_init_default;
    tria_SensorPacket sensor = tria_SensorPacket_init_default;
    bool udp_initialized = false;

    multicore_launch_core1(udp_task);

    absolute_time_t last_time = get_absolute_time();

    // これがtrueならrobomaster、falseならmdに対してCAN送信を行う
    bool md_or_robomaster = true;

    while (true) 
    {   
        mutex_enter_blocking(&g_mutex);
        command = g_data.command_packet;
        g_data.sensor_packet = sensor;
        udp_initialized = g_data.udp_status;
        mutex_exit(&g_mutex);

        gpio_put(PICO_DEFAULT_LED_PIN, udp_initialized);

        int16_t tmp = command.horizontal_motor;
        can_send_msg.data[0] = (tmp >> 8) & 0xFF;
        can_send_msg.data[1] = tmp & 0xFF;
        tmp = command.vertical_motor;
        can_send_msg.data[2] = (tmp >> 8) & 0xFF;
        can_send_msg.data[3] = tmp & 0xFF;
        tmp = command.hand_motor;
        can_send_msg.data[4] = (tmp >> 8) & 0xFF;
        can_send_msg.data[5] = tmp & 0xFF;

        tmp = command.wheel1;
        md_send_msg.data[0] = (tmp >> 8) & 0xFF;
        md_send_msg.data[1] = tmp & 0xFF;
        tmp = command.wheel2;
        md_send_msg.data[2] = (tmp >> 8) & 0xFF;
        md_send_msg.data[3] = tmp & 0xFF;
        tmp = command.wheel3;
        md_send_msg.data[4] = (tmp >> 8) & 0xFF;
        md_send_msg.data[5] = tmp & 0xFF;


        absolute_time_t now = get_absolute_time();
        // 前回実行時からの経過時間（マイクロ秒）を計算
        int64_t diff_us = absolute_time_diff_us(last_time, now);

        if(diff_us >= 10000)
        {
            if(md_or_robomaster)
            {
                if(can_transmit(can_send_msg))
                {
                    gpio_put(2, true);
                }
                else
                {
                    gpio_put(2, false);
                }
            }
            else
            {
                if(can_transmit(md_send_msg))
                {
                    gpio_put(2, true);
                }
                else
                {
                    gpio_put(2, false);
                }
            }

            md_or_robomaster = !md_or_robomaster;
            last_time = delayed_by_us(last_time, 10000);
        }
        
        struct can2040_msg can_recv_msg;
        if(can_receive(&can_recv_msg))
        {
            if(can_recv_msg.id == 0x201)
            {
                hp_parse_CANMessage(can_recv_msg.data, &rm1);
                sensor.can_id = can_recv_msg.id - 0x200;
                sensor.angle = rm1.position * 100;
                sensor.velocity = rm1.velocity;
                sensor.torque = rm1.torque;
            }
            if(can_recv_msg.id == 0x202)
            {
                hp_parse_CANMessage(can_recv_msg.data, &rm2);
                sensor.can_id = can_recv_msg.id - 0x200;
                sensor.angle = rm2.position * 100;
                sensor.velocity = rm2.velocity;
                sensor.torque = rm2.torque;
            }
            if(can_recv_msg.id == 0x203)
            {
                hp_parse_CANMessage(can_recv_msg.data, &rm3);
                sensor.can_id = can_recv_msg.id - 0x200;
                sensor.angle = rm3.position * 100;
                sensor.velocity = rm3.velocity;
                sensor.torque = rm3.torque;
            }

            gpio_put(3, true);

            // CAN受信キューにデータがある場合
        }
        else
        {
            gpio_put(3, false);
        }
    }
}
