motii8128/TRIA/(commit log)

2026-09-10 [update] 基板データのアップデート
    [TRIA_CentralControlBoard.kicad_pcb, TRIA_CentralControlBoard.kicad_sch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]
2026-09-10 [fix] ディレクトリ名を変更
2026-09-10 [new] LANとCANを仲介するFirmwareの追加
2026-09-10 [fix] 不要なファイルを削除
2026-09-16 [fix] 不要なライブラリの削除
2026-09-16 [update] LAN2CAN_Bridgeの雛形を作成。コア１でのUDPを実装
2026-09-16 [fix] 書き忘れ
2026-09-16 [update] Gerber生成&LED制御基板の設計が完了
    [TRIA_CentralControlBoard-B_Cu.gbr, TRIA_CentralControlBoard-B_Mask.gbr, TRIA_CentralControlBoard-B_Paste.gbr, TRIA_CentralControlBoard-B_Silkscreen.gbr, TRIA_CentralControlBoard-Edge_Cuts.gbr, TRIA_CentralControlBoard-F_Cu.gbr, TRIA_CentralControlBoard-F_Mask.gbr, TRIA_CentralControlBoard-F_Paste.gbr]
2026-09-30 [update] 通信定義の更新
2026-09-30 [new] MotorDriverのファームウェアを作成(未完成)
2026-09-30 [update] STEPファイルの作成
    [TRIA_ControlPowerBoard.step]
2026-09-30 [update] アーキテクチャの大幅な変更
2026-10-04 [new] 制御アーキテクチャの作成
2026-10-04 [new] tria_common_utilsの追加
2026-10-04 [update] 型の追加
2026-10-07 [fix] PWMまわりの修正
2026-10-07 [new] zenohpbの追加
2026-10-07 [update] 必要なメッセージ型定義の追加
2026-10-07 [update] 基本ノードはtria_core内に作成することに決定
2026-10-08 [new] PIDライブラリの追加
2026-10-08 [update]カスケード制御の追加
2026-10-19 [fix] Rustパッケージをすべて削除。ROS2に移行する
2026-10-19 [new] ROS2カスタムメッセージを追加
2026-10-19 [fix] msg生成部分の依存関係を修正
2026-10-21 [new] マイコンとの通信パッケージを作成
2026-10-21 [new] Launchパッケージの追加& ccb_communicatorのlaunchを追加
2026-10-21 [fix] 生成されたプロトコルバッファーのコードをincludeしたいので
2026-10-21 [new] 足回りに比例制御を行うノードの作成
2026-10-21 [new] launchの追加
2026-10-21 [new] 一括launchの追加
2026-10-21 [new] 機構のPID制御を追加
2026-10-23 [fix] 通信エラーを取り除いて動作確認した
2026-10-23 [fix] CCBの修正箇所を更新
2026-10-23 [fix] 動作確認のための修正
2026-10-23 [fix] 総回転数計測に誤差が出たときのために更新
2026-10-23 [new] ゲームコントローラー接続の追加
2026-10-23 [new] game_controllerまわりのlaunch完成
2026-10-28 [fix] tria_auto_plannerではなくtria_auto_coreに変更
2026-10-28 [new] 自律走行に関するカスタムメッセージを追加
2026-10-28 [new] tminiドライバーの追加(by claude)
2026-10-29 [fix] 動作確認による修正
2026-10-29 [update] 機構のパラメータチューニング完了
2026-10-29 [fix] executableの名前を修正
2026-10-29 [new] Claude君にWeb UI作らせたらすごいのできた
2026-10-30 [new] Web UIと接続する部分を作成。Jsonをstringで渡してる
2026-10-30 [update] PIDパラメータの調整
2026-10-30 [update] 足回りの動作確認完了
2026-10-30 [update] 手動機としてコントローラーを移動に対応させた
2026-10-30 [update] 手動機としての動作確認をするために整理
2026-10-30 [new] ２つの点群を統合する部分を作成
2026-10-30 [new] ２次元KdTreeの実装
2026-10-30 [fix] トピック名の修正
2026-10-30 [new] LiDARオンリー自己位置推定の追加
2026-10-30 [update] 処理を高速化
2026-10-30 [fix] 実機に合わせてパラメータを変更
2026-10-30 [fix] パラメータの追加忘れ
2026-11-01 [update] センサーではなく、目標値側に同期するよう変更
2026-11-01 [new] TaskManagerの追加
2026-11-01 [update] パラメータに対応
2026-11-01 [update] 各機能のLaunchを１ファイルに統合
2026-11-01 [new] スクリプトの追加
2026-11-01 [fix] 権限の追加
2026-11-01 [fix] バイナリ見つけれないエラーを修正
2026-11-01 [fix] テスト時での修正
2026-11-02 [fix] 実験によるLiDAR位置の調整
2026-11-02 [update] 自らのボディの点群除去を追加
2026-11-02 [fix] パラメータの修正
2026-11-02 [update] パラメータの変更＆姿勢変換方法の変更
2026-11-02 [fix] 掴む際の仕様を修正
2026-11-02 [fix] 手動機実験のための変更
2026-11-02 [update] 収束しなかった場合には位置を更新しない
2026-11-02 [new] シンプルなPIDによるplannerを追加
2026-11-02 [fix] PidPlannerがうごかないバグを修正
2026-11-02 [update] 実験によるアップデート
2026-11-04 [new] icp_scan_mapperの追加
2026-11-04 [fix] 回らないバグの修正
2026-11-04 [update] icp_scan_mapperを追加
2026-11-04 [fix] ビルドエラーを修正
2026-11-04 [fix] 最大値を修正
2026-11-04 [update] 大幅な仕様変更 ScanMapper側でOdomをPublishする
2026-11-04 [update] 速度ベクトルをワールド系に変換
2026-11-04 [update] ロボットの見た目の向きを修正
2026-11-04 [fix] ワールド系への変換を修正
2026-11-04 [update] 機構展開位置に合わせて目標位置を計算するようにした
2026-11-04 [update] ICPのマップ点群の範囲を狭めた
2026-11-04 [fix] パラメータの調整
2026-11-05 [fix] 足回りのみでテストする状態にした
2026-11-05 [update] ゴール判定に角度も追加
2026-11-05 [update] 取得する点群の範囲を広くした
2026-11-05 [fix] 自己位置のVisualizeを修正
2026-11-05 [update] パラメータ調整
2026-11-05 [fix] task managerの危ないエラーを消去
2026-11-09 [fix] 基板の更新はもうないのでignore
2026-11-11 [fix] 実機調整。全自動完了
